adafruit/Adafruit-MONSTER-M4SK-PCB/Adafruit MONSTER M4SK.sch

## EAGLE design Adafruit MONSTER M4SK.sch (2019-09-24)

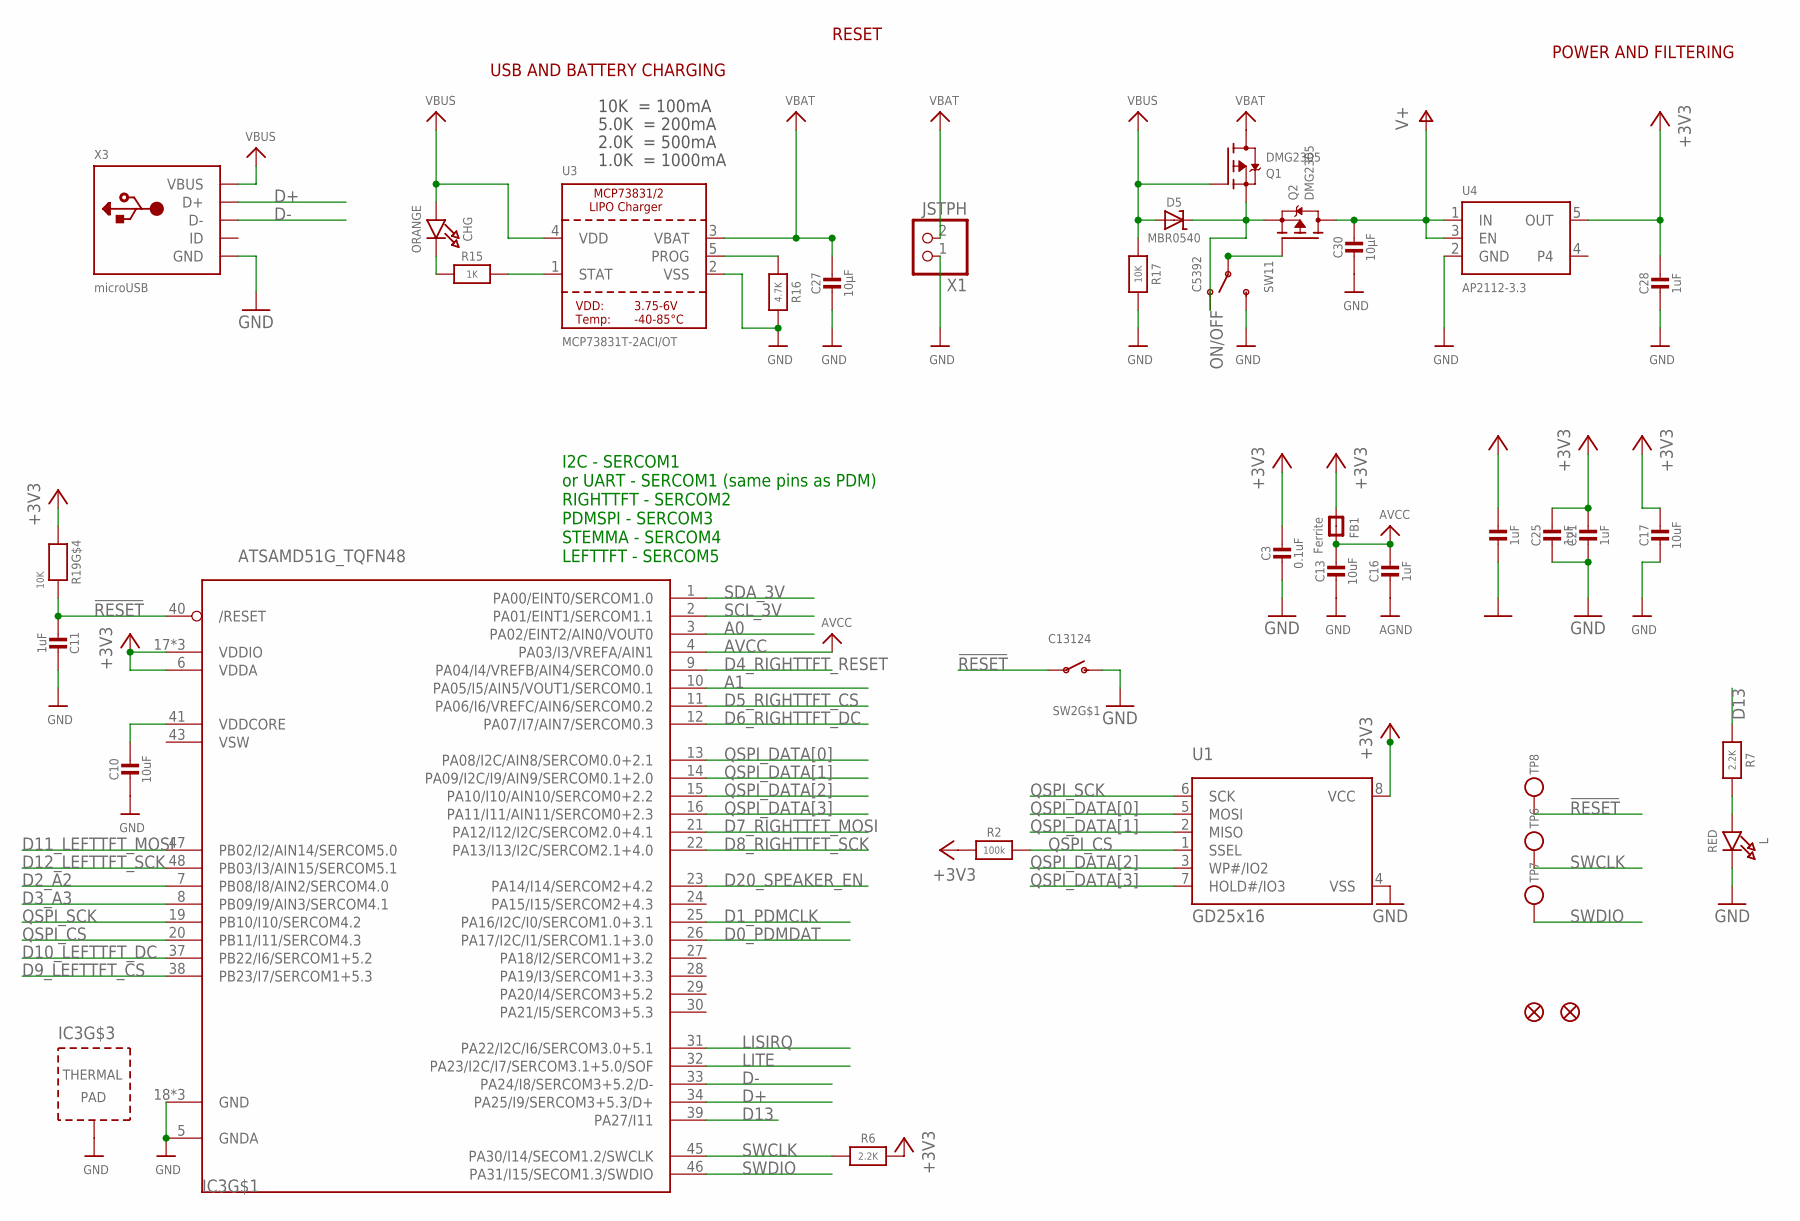
[picture p2: schematic Adafruit MONSTER M4SK.sch, sheet 1]

Parts:
C3: 0.1uF; 0603-NO
C10: 10uF; _0805MP
C11, C16, C19, C21, C25, C28: 1uF; 0603-NO
C13, C17: 10uF; 0805-NO
C27, C30: 10µF; 0805-NO
CHG: ORANGE; CHIPLED_0805_NOOUTLINE
D5: MBR0540; SOD-123
FB1: Ferrite; 0805-NO
IC3: ATSAMD51G_TQFN48; TQFN48_7MM
L: RED; CHIPLED_0805_NOOUTLINE
Q1, Q2: DMG2305; SOT23-R
R2: 100k; 0603-NO
R6, R7: 2.2K; 0603-NO
R15: 1K; 0603-NO
R16: 4.7K; 0603-NO
R17: 10K; 0603-NO
R19: 10K; RESPACK_4X0603
SW2: C13124; SPST_TACTILE_RA
SW11: C5392; SPDT_SMT_SSSS811101
TP6, TP7, TP8: TESTPOINTROUND2MMNO; TESTPOINT_ROUND_2MM_NO
U1: GD25x16; SOIC8_208MIL
U3: MCP73831T-2ACI/OT; SOT23-5
U4: AP2112-3.3; SOT23-5
U$34, U$35: FIDUCIAL_1MM
X1: JSTPH; JSTPH2
X3: microUSB; 4UCONN_20329_NARROW

Connections:
!RESET: C11.2, IC3.40 (/RESET), R19.5 (2), SW2.1, TP8.P$1
+3V3: C3.1, C17.1, C19.1, C21.1, C25.1, C28.1, FB1.1, IC3.6 (VDDA), IC3.17 (VDDIO), R2.1, R6.2, R19.4 (1), U1.8 (VCC), U4.5 (OUT)
A0: IC3.3 (PA02/EINT2/AIN0/VOUT0)
A1: IC3.10 (PA05/I5/AIN5/VOUT1/SERCOM0.1)
AGND: C16.2
AVCC: C13.1, C16.1, FB1.2, IC3.4 (PA03/I3/VREFA/AIN1)
CHG_LED: R15.2, U3.1 (STAT)
CHG_RATE: R16.1, U3.5 (PROG)
D0_PDMDAT: IC3.26 (PA17/I2C/I1/SERCOM1.1+3.0)
D1_PDMCLK: IC3.25 (PA16/I2C/I0/SERCOM1.0+3.1)
D2_A2: IC3.7 (PB08/I8/AIN2/SERCOM4.0)
D3_A3: IC3.8 (PB09/I9/AIN3/SERCOM4.1)
D4_RIGHTTFT_RESET: IC3.9 (PA04/I4/VREFB/AIN4/SERCOM0.0)
D5_RIGHTTFT_CS: IC3.11 (PA06/I6/VREFC/AIN6/SERCOM0.2)
D6_RIGHTTFT_DC: IC3.12 (PA07/I7/AIN7/SERCOM0.3)
D7_RIGHTTFT_MOSI: IC3.21 (PA12/I12/I2C/SERCOM2.0+4.1)
D8_RIGHTTFT_SCK: IC3.22 (PA13/I13/I2C/SERCOM2.1+4.0)
D9_LEFTTFT_CS: IC3.38 (PB23/I7/SERCOM1+5.3)
D10_LEFTTFT_DC: IC3.37 (PB22/I6/SERCOM1+5.2)
D11_LEFTTFT_MOSI: IC3.47 (PB02/I2/AIN14/SERCOM5.0)
D12_LEFTTFT_SCK: IC3.48 (PB03/I3/AIN15/SERCOM5.1)
D13: IC3.39 (PA27/I11), R7.1
D20_SPEAKER_EN: IC3.23 (PA14/I14/SERCOM2+4.2)
D+: IC3.34 (PA25/I9/SERCOM3+5.3/D+), X3.D+
D-: IC3.33 (PA24/I8/SERCOM3+5.2/D-), X3.D-
GND: C3.2, C10.2, C11.1, C13.2, C17.2, C19.2, C21.2, C25.2, C27.2, C28.2, C30.2, IC3.5 (GNDA), IC3.18 (GND), IC3.THERMAL (TP), L.C, R16.2, R17.2, SW2.2 (S), SW11.C (S), U1.4 (VSS), U3.2 (VSS), U4.2 (GND), X1.1, X3.BASE@1 (GND)
LISIRQ: IC3.31 (PA22/I2C/I6/SERCOM3.0+5.1)
LITE: IC3.32 (PA23/I2C/I7/SERCOM3.1+5.0/SOF)
unnamed: L.A, R7.2
unnamed: CHG.C, R15.1
unnamed: D5.C, Q1.2 (S), Q2.2 (S), SW11.A (O)
ON/OFF: Q2.1 (G), SW11.B
QSPI_CS: IC3.20 (PB11/I11/SERCOM4.3), R2.2, U1.1 (SSEL)
QSPI_DATA[0]: IC3.13 (PA08/I2C/AIN8/SERCOM0.0+2.1), U1.5 (MOSI)
QSPI_DATA[1]: IC3.14 (PA09/I2C/I9/AIN9/SERCOM0.1+2.0), U1.2 (MISO)
QSPI_DATA[2]: IC3.15 (PA10/I10/AIN10/SERCOM0+2.2), U1.3 (WP#/IO2)
QSPI_DATA[3]: IC3.16 (PA11/I11/AIN11/SERCOM0+2.3), U1.7 (HOLD#/IO3)
QSPI_SCK: IC3.19 (PB10/I10/SERCOM4.2), U1.6 (SCK)
SCL_3V: IC3.2 (PA01/EINT1/SERCOM1.1)
SDA_3V: IC3.1 (PA00/EINT0/SERCOM1.0)
SWCLK: IC3.45 (PA30/I14/SECOM1.2/SWCLK), R6.1, TP6.P$1
SWDIO: IC3.46 (PA31/I15/SECOM1.3/SWDIO), TP7.P$1
V+: C30.1, Q2.3 (D), U4.1 (IN), U4.3 (EN)
VBAT: C27.1, Q1.3 (D), U3.3 (VBAT), X1.2
VBUS: CHG.A, D5.A, Q1.1 (G), R17.1, U3.4 (VDD), X3.VBUS
VDDCORE: C10.1, IC3.41 (VDDCORE)

Notes on the sheet:
RESET
10K = 100mA
5.0K = 200mA
2.0K = 500mA
1.0K = 1000mA
USB AND BATTERY CHARGING
POWER AND FILTERING
I2C - SERCOM1 or UART - SERCOM1 (same pins as PDM) RIGHTTFT - SERCOM2 PDMSPI - SERCOM3 STEMMA - SERCOM4 LEFTTFT - SERCOM5

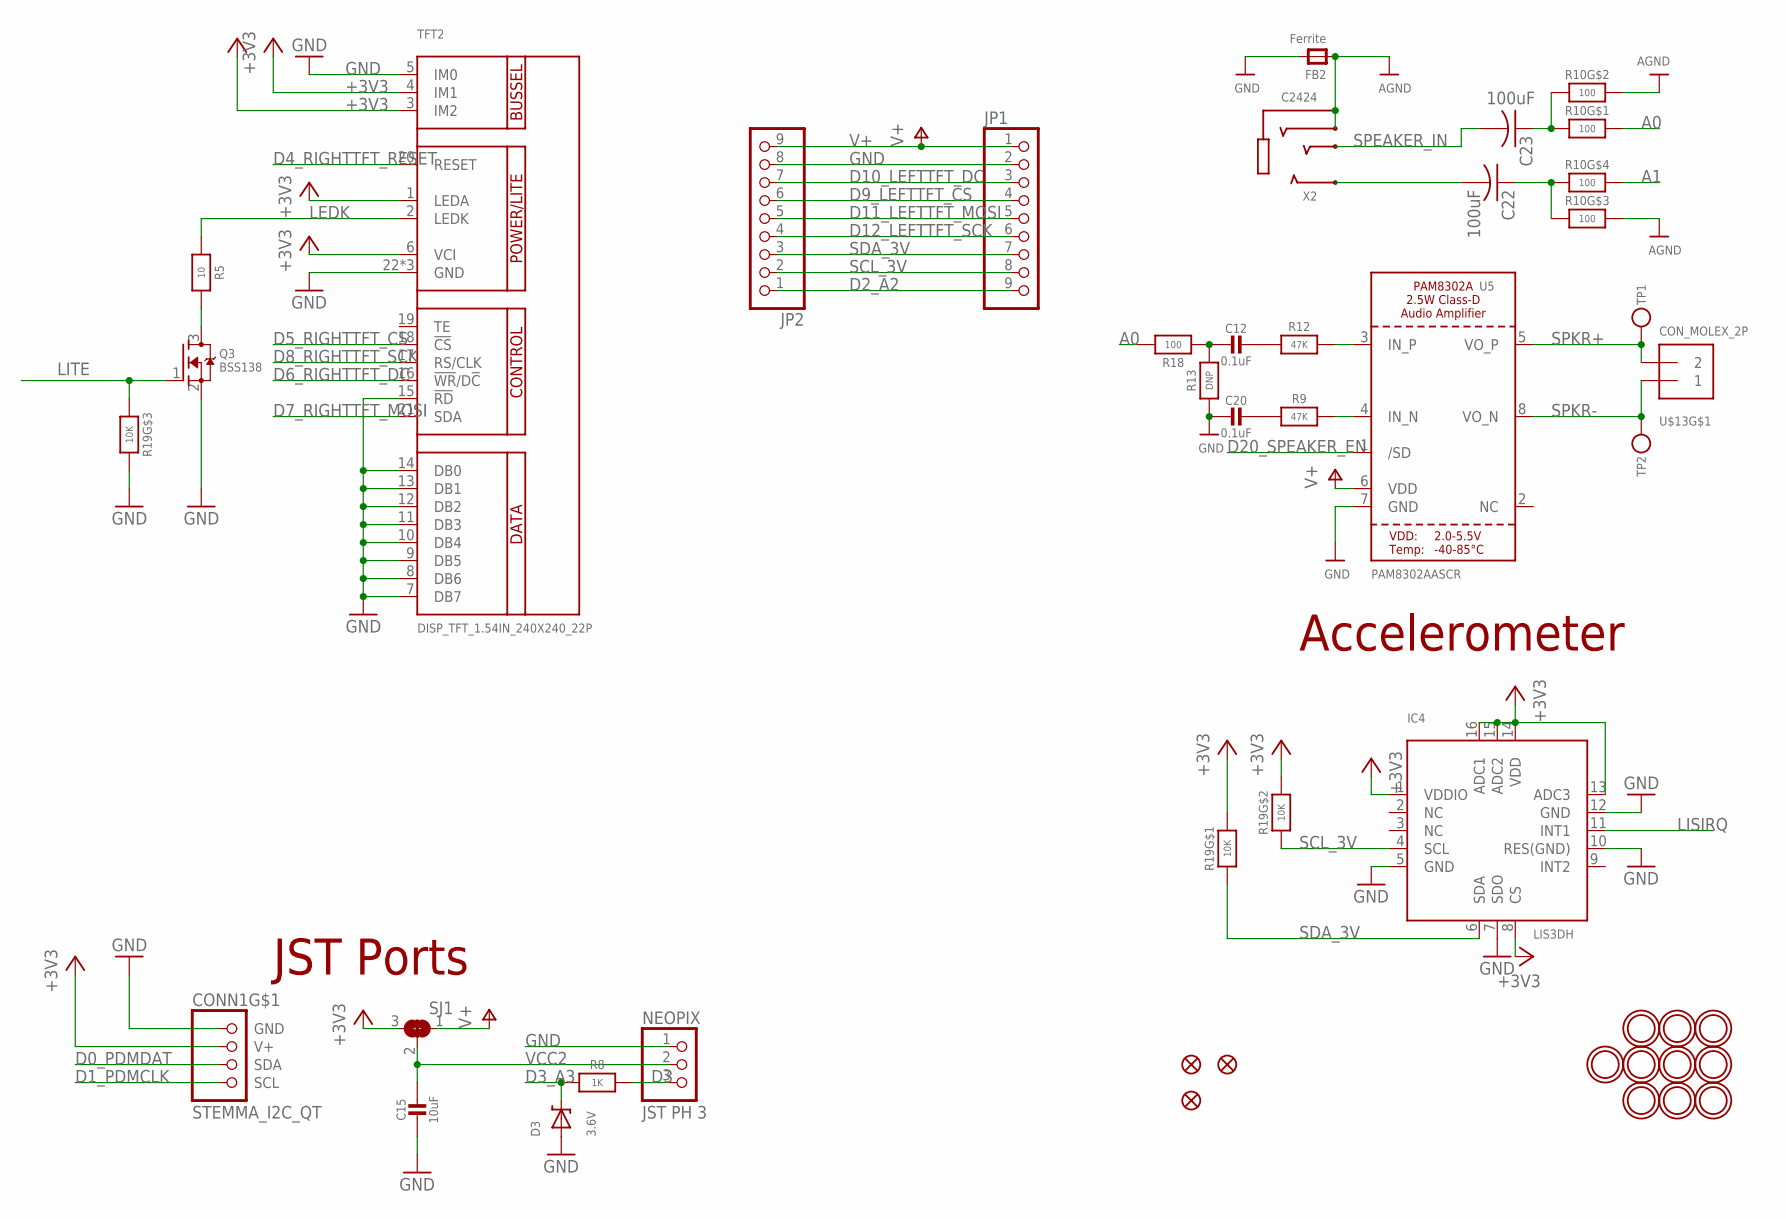
[picture p3: schematic Adafruit MONSTER M4SK.sch, sheet 2]

Parts:
C12, C20: 0.1uF; 0603-NO
C15: 10uF; 0805-NO
C22, C23: 100uF; C1210
CONN1: STEMMA_I2C_QT; JST_SH4
D3: 3.6V; SOD-323
FB2: Ferrite; _0805MP
IC4: LIS3DH; LGA16_3X3MM
JP1, JP2: HEADER-1X9_JSTSH; JST_SH9
NEOPIX: JST PH 3; JSTPH3
Q3: BSS138; SOT23-WIDE
R5: 10; 0603-NO
R8: 1K; 0603-NO
R9, R12: 47K; 0603-NO
R10: 100; RESPACK_4X0603
R13: DNP; 0603-NO
R18: 100; 0603-NO
R19: 10K; RESPACK_4X0603
SJ1: SOLDERJUMPER_2WAY; SOLDERJUMPER_2WAY_OPEN_NOPASTE
TFT2: DISP_TFT_1.54IN_240X240_22P; TFT_1.54IN_240X240_22PIN
TP1, TP2: TESTPOINTROUND1.5MMNO; TESTPOINT_ROUND_1.5MM_NO
U5: PAM8302AASCR; MSOP8_0.65MM
U$3, U$4, U$5: FIDUCIAL_1MM
U$7, U$8, U$9, U$10, U$58, U$59, U$60, U$61, U$63, U$64: MOUNTINGHOLE3.0THIN; MOUNTINGHOLE_3.0_PLATEDTHIN
U$13: CON_MOLEX_2P; 53398-0271
X2: C2424; 4UCONN_18510

Connections:
+3V3: CONN1.2 (V+), IC4.1 (VDDIO), IC4.8 (CS), IC4.13 (ADC3), IC4.14 (VDD), IC4.15 (ADC2), IC4.16 (ADC1), R19.1, R19.2 (1), SJ1.3, TFT2.1 (LEDA), TFT2.3 (IM2), TFT2.4 (IM1), TFT2.6 (VCI)
A0: R10.8 (2), R18.2
A1: R10.5 (2)
AGND: FB2.1, R10.6 (2), R10.7 (2), X2.1-GND (TIP), X2.4-INNER_SLEEVE (RING1)
D0_PDMDAT: CONN1.3 (SDA)
D1_PDMCLK: CONN1.4 (SCL)
D2_A2: JP1.9, JP2.1
D3: NEOPIX.3, R8.1
D3_A3: D3.C, R8.2
D4_RIGHTTFT_RESET: TFT2.20 (RESET)
D5_RIGHTTFT_CS: TFT2.18 (!CS)
D6_RIGHTTFT_DC: TFT2.16 (!WR!/D!C)
D7_RIGHTTFT_MOSI: TFT2.21 (SDA)
D8_RIGHTTFT_SCK: TFT2.17 (RS/CLK)
D9_LEFTTFT_CS: JP1.4, JP2.6
D10_LEFTTFT_DC: JP1.3, JP2.7
D11_LEFTTFT_MOSI: JP1.5, JP2.5
D12_LEFTTFT_SCK: JP1.6, JP2.4
D20_SPEAKER_EN: U5.1 (/SD)
GND: C15.2, C20.2, CONN1.1 (GND), D3.A, FB2.2, IC4.5 (GND), IC4.7 (SDO), IC4.10 (RES(GND)), IC4.12 (GND), JP1.2, JP2.8, NEOPIX.1, Q3.2 (S), R13.1, R19.3 (1), TFT2.5 (IM0), TFT2.7 (DB7), TFT2.8 (DB6), TFT2.9 (DB5), TFT2.10 (DB4), TFT2.11 (DB3), TFT2.12 (DB2), TFT2.13 (DB1), TFT2.14 (DB0), TFT2.15 (!RD), TFT2.22 (GND), U5.7 (GND)
LEDK: R5.2, TFT2.2 (LEDK)
LISIRQ: IC4.11 (INT1)
LITE: Q3.1 (G), R19.6 (2)
unnamed: Q3.3 (D), R5.1
unnamed: R9.2, U5.4 (IN_N)
unnamed: R12.2, U5.3 (IN_P)
unnamed: C12.2, R13.2, R18.1
unnamed: C22.2, X2.3-OUTER_SLEEVE (RING2)
unnamed: C22.1, R10.3 (1), R10.4 (1)
unnamed: C20.1, R9.1
unnamed: C12.1, R12.1
unnamed: C23.1, R10.1, R10.2 (1)
SCL_3V: IC4.4 (SCL), JP1.8, JP2.2, R19.7 (2)
SDA_3V: IC4.6 (SDA), JP1.7, JP2.3, R19.8 (2)
SPEAKER_IN: C23.2, X2.2-TIP (RING3)
SPKR+: TP1.P$1, U5.5 (VO_P), U$13.2
SPKR-: TP2.P$1, U5.8 (VO_N), U$13.1
V+: JP1.1, JP2.9, SJ1.1, U5.6 (VDD)
VCC2: C15.1, NEOPIX.2, SJ1.2

Notes on the sheet:
JST Ports
Accelerometer

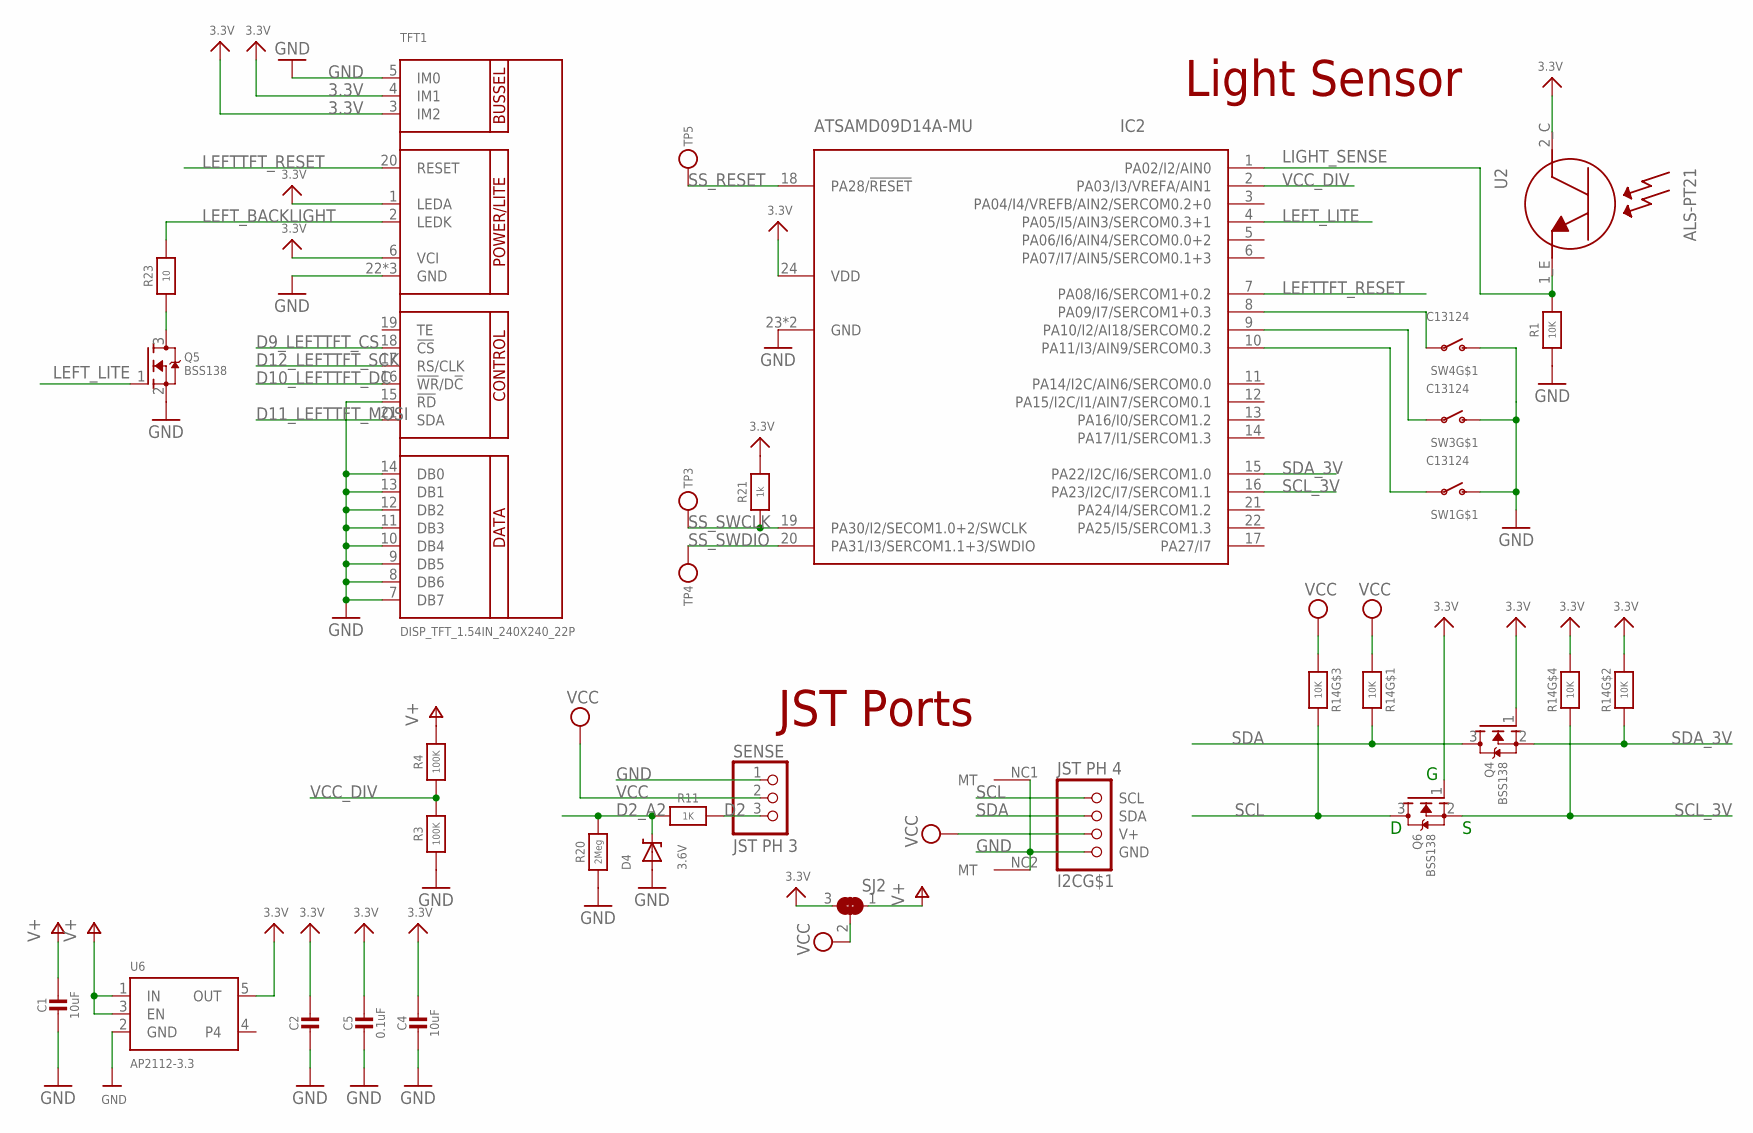
[picture p4: schematic Adafruit MONSTER M4SK.sch, sheet 3]

Parts:
C1, C2, C4: 10uF; 0805-NO
C5: 0.1uF; 0603-NO
D4: 3.6V; SOD-323
I2C: JST PH 4; JSTPH4
IC2: ATSAMD09D14A-MU; QFN24_4MM
Q4, Q5, Q6: BSS138; SOT23-WIDE
R1: 10K; 0603-NO
R3, R4: 100K; 0603-NO
R11: 1K; 0603-NO
R14: 10K; RESPACK_4X0603
R20: 2Meg; 0603-NO
R21: 1k; 0603-NO
R23: 10; 0603-NO
SENSE: JST PH 3; JSTPH3
SJ2: SOLDERJUMPER_2WAY; SOLDERJUMPER_2WAY_OPEN_NOPASTE
SW1, SW3, SW4: C13124; SPST_TACTILE_RA
TFT1: DISP_TFT_1.54IN_240X240_22P; TFT_1.54IN_240X240_22PIN
TP3, TP4, TP5: TESTPOINTROUND2MM; TESTPOINT_ROUND_2MM
U2: ALS-PT21; ALS-PT26-21C
U6: AP2112-3.3; SOT23-5

Connections:
3.3V: C2.1, C4.1, C5.1, IC2.24 (VDD), Q4.1 (G), Q6.1 (G), R14.2 (1), R14.4 (1), R21.2, SJ2.3, TFT1.1 (LEDA), TFT1.3 (IM2), TFT1.4 (IM1), TFT1.6 (VCI), U2.2_C (C), U6.5 (OUT)
D2: R11.1, SENSE.3
D2_A2: D4.C, R11.2, R20.2
D9_LEFTTFT_CS: TFT1.18 (!CS)
D10_LEFTTFT_DC: TFT1.16 (!WR!/D!C)
D11_LEFTTFT_MOSI: TFT1.21 (SDA)
D12_LEFTTFT_SCK: TFT1.17 (RS/CLK)
GND: C1.2, C2.2, C4.2, C5.2, D4.A, I2C.1 (GND), I2C.NC1 (MT), I2C.NC2 (MT), IC2.23 (GND), Q5.2 (S), R1.1, R3.1, R20.1, SENSE.1, SW1.2 (S), SW3.2 (S), SW4.2 (S), TFT1.5 (IM0), TFT1.7 (DB7), TFT1.8 (DB6), TFT1.9 (DB5), TFT1.10 (DB4), TFT1.11 (DB3), TFT1.12 (DB2), TFT1.13 (DB1), TFT1.14 (DB0), TFT1.15 (!RD), TFT1.22 (GND), U6.2 (GND)
LEFTTFT_RESET: IC2.7 (PA08/I6/SERCOM1+0.2), TFT1.20 (RESET)
LEFT_BACKLIGHT: R23.2, TFT1.2 (LEDK)
LEFT_LITE: IC2.4 (PA05/I5/AIN3/SERCOM0.3+1), Q5.1 (G)
LIGHT_SENSE: IC2.1 (PA02/I2/AIN0), R1.2, U2.1_E (E)
unnamed: Q5.3 (D), R23.1
unnamed: IC2.8 (PA09/I7/SERCOM1+0.3), SW4.1
unnamed: IC2.9 (PA10/I2/AI18/SERCOM0.2), SW3.1
unnamed: IC2.10 (PA11/I3/AIN9/SERCOM0.3), SW1.1
SCL: I2C.4 (SCL), Q6.3 (D), R14.6 (2)
SCL_3V: IC2.16 (PA23/I2C/I7/SERCOM1.1), Q6.2 (S), R14.5 (2)
SDA: I2C.3 (SDA), Q4.3 (D), R14.8 (2)
SDA_3V: IC2.15 (PA22/I2C/I6/SERCOM1.0), Q4.2 (S), R14.7 (2)
SS_RESET: IC2.18 (PA28/!RESET), TP5.P$1
SS_SWCLK: IC2.19 (PA30/I2/SECOM1.0+2/SWCLK), R21.1, TP3.P$1
SS_SWDIO: IC2.20 (PA31/I3/SERCOM1.1+3/SWDIO), TP4.P$1
V+: C1.1, R4.2, SJ2.1, U6.1 (IN), U6.3 (EN)
VCC: I2C.2 (V+), R14.1, R14.3 (1), SENSE.2, SJ2.2
VCC_DIV: IC2.2 (PA03/I3/VREFA/AIN1), R3.2, R4.1

Notes on the sheet:
Light Sensor
JST Ports
